eliecudkowicz/Implementation-of-Hummingbird-Encryption-Algorithm/Hummingbird-2 codes/hummingbird_top.v

//------------------------------------------------------------------
// Project Name: Implementation of Hummingbird Encryption Algorithm
// Team Number:  xohw21-114
// Participants: Elie Cudkowicz, Itamar Yunnian
// Supervisor:	 Uri Stroh
// Date:		 June 2021
//------------------------------------------------------------------

module hummingbird_top (
	// inputs
	input 			clk,
	input			rst,
	input 	[127:0] key,
	input 	[127:0] pt,
	input 	[63:0]  iv,
	// output
	output	[127:0]	ct
);

//internal signals
	// internal registers for first word
     wire [15:0] r1_in;
	 wire [15:0] r2_in;
	 wire [15:0] r3_in;
	 wire [15:0] r4_in;
	 wire [15:0] r5_in;
	 wire [15:0] r6_in;
	 wire [15:0] r7_in;
	 wire [15:0] r8_in;
	// internal registers for second word
	 wire [15:0] r1_w1;
	 wire [15:0] r2_w1;
	 wire [15:0] r3_w1;
	 wire [15:0] r4_w1;
	 wire [15:0] r5_w1;
	 wire [15:0] r6_w1;
	 wire [15:0] r7_w1;
	 wire [15:0] r8_w1;
	// internal registers for third word
	 wire [15:0] r1_w2;
	 wire [15:0] r2_w2;
	 wire [15:0] r3_w2;
	 wire [15:0] r4_w2;
	 wire [15:0] r5_w2;
	 wire [15:0] r6_w2;
	 wire [15:0] r7_w2;
	 wire [15:0] r8_w2;
	// internal registers for fourth word 
	 wire [15:0] r1_w3;
	 wire [15:0] r2_w3;
	 wire [15:0] r3_w3;
	 wire [15:0] r4_w3;
	 wire [15:0] r5_w3;
	 wire [15:0] r6_w3;
	 wire [15:0] r7_w3;
	 wire [15:0] r8_w3;
	// internal registers for fifth word 
	 wire [15:0] r1_w4;
	 wire [15:0] r2_w4;
	 wire [15:0] r3_w4;
	 wire [15:0] r4_w4;
	 wire [15:0] r5_w4;
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
	encryption w8 (	clk,
					rst,
					pt[15:0],
					key,
					r1_w7,
					r2_w7,
					r3_w7,
					r4_w7,
					r5_w7,
					r6_w7,
					r7_w7,
					r8_w7,
					ct [15:0],
					r1_w8,
					r2_w8,
					r3_w8,
					r4_w8,
					r5_w8,
					r6_w8,
					r7_w8,
					r8_w8
	);

endmodule
